BrownDogGadgets/CrazyCircuits/Circuit-Kits/Modules/2x3-Dark-Detector/2x3-Dark-Detector.kicad_pcb

## KiCad design Circuit-Kits/Modules/2x3-Dark-Detector/2x3-Dark-Detector.kicad_pcb (2018-09-25)

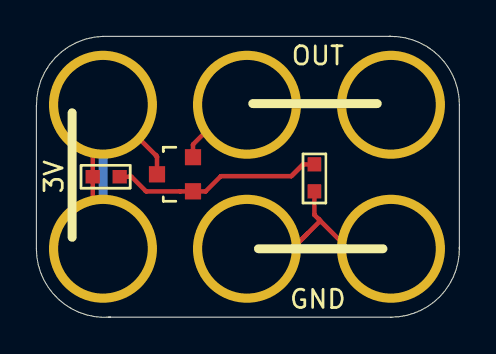
[picture p4: board 2x3-Dark-Detector.kicad_pcb from above]

Board: 2 copper layers, 23.5 x 15.6 mm, 3 parts (0 on the bottom side), 2 nets.

Parts:
LDR1: PHOTOCELL; RLC-0603-SMD
Q1: NPN MMBT3904; SOT-23-3
R1: 100K; RLC-0603-SMD

Connections:
3V: Q1.3, R1.1
unnamed: LDR1.2, Q1.1, R1.2
