BrownDogGadgets/CrazyCircuits/Circuit-Kits/Modules/8x12-PocketBeagle-Breakout/8x12-PocketBeagle-Breakout.kicad_pcb

## KiCad design Circuit-Kits/Modules/8x12-PocketBeagle-Breakout/8x12-PocketBeagle-Breakout.kicad_pcb (2018-08-06)

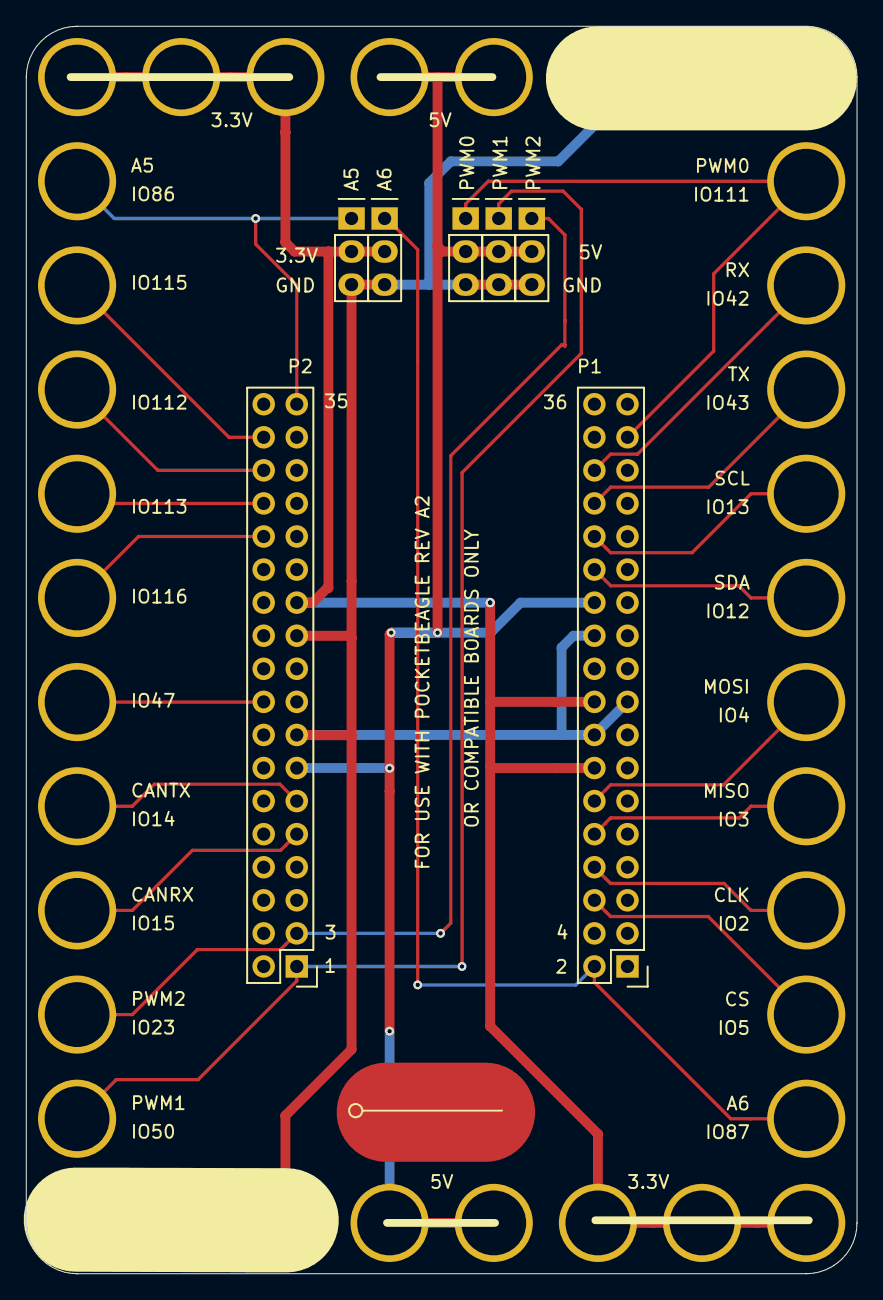
[picture p5: board 8x12-PocketBeagle-Breakout.kicad_pcb from above]

Board: 2 copper layers, 63.8 x 95.8 mm, 7 parts (0 on the bottom side), 8 nets.

Parts:
J1, J2, J3, J4, J5: HEADER; CONN-HEADER-STRAIGHT-P2.54MM-1x03
J6: POCKET-BEAGLE; POCKET-BEAGLE-8x12
LOGO: BROWN DOG; LOGO-CRAZY-1x2

Connections:
3.3V: J4.2, J5.2, J6.P114, J6.P118, J6.P223
5V: J1.2, J2.2, J3.2, J6.P124, J6.P213
/A5: J4.1, J6.P235
/A6: J5.1, J6.P102
/PWM0: J1.1, J6.P133
/PWM1: J2.1, J6.P201
/PWM2: J3.1, J6.P203
GND: J1.3, J2.3, J3.3, J4.3, J5.3, J6.P116, J6.P117, J6.P122, J6.P215, J6.P221
