BrownDogGadgets/CrazyCircuits/Circuit-Kits/Modules/6x10-Photon-Breakout/6x10-Photon-Breakout.kicad_pcb

## KiCad design Circuit-Kits/Modules/6x10-Photon-Breakout/6x10-Photon-Breakout.kicad_pcb (2018-07-31)

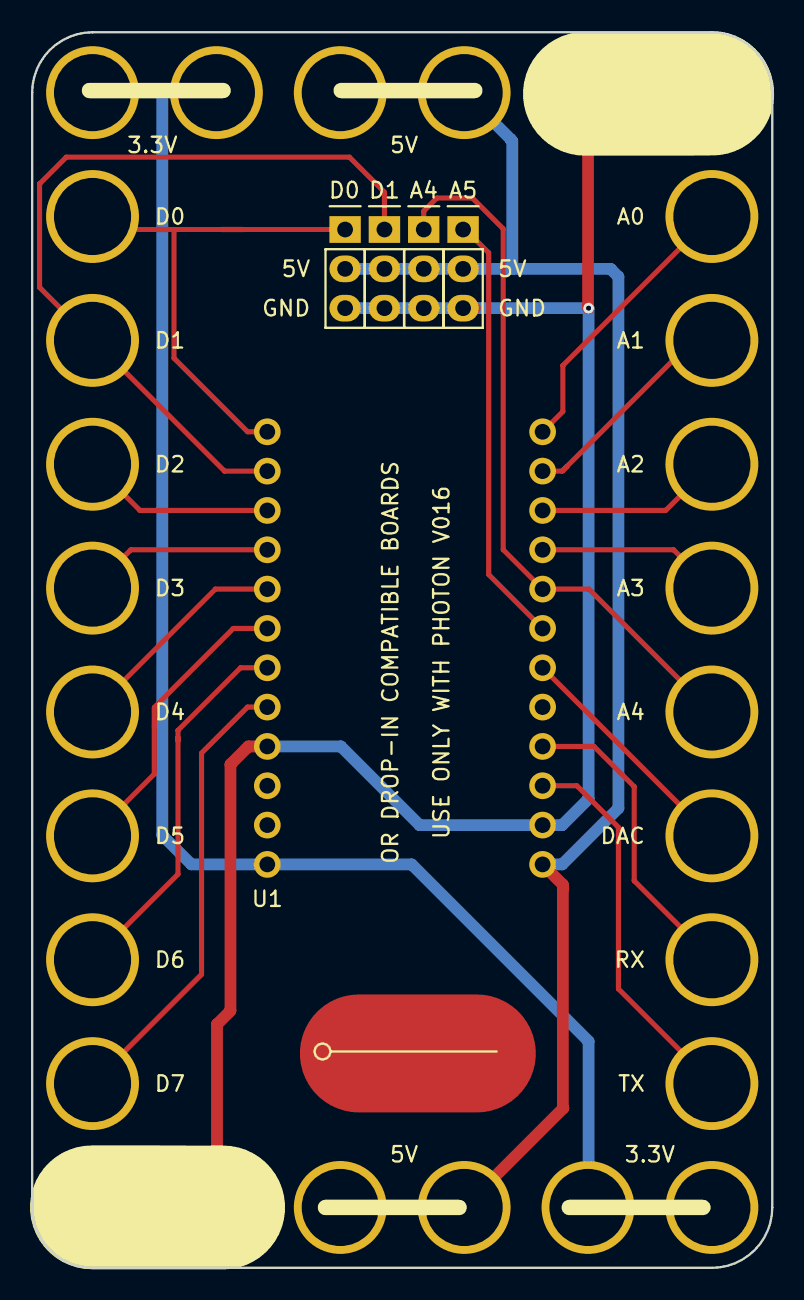
[picture p6: board 6x10-Photon-Breakout.kicad_pcb from above]

Board: 2 copper layers, 47.8 x 79.8 mm, 6 parts (0 on the bottom side), 6 nets.

Parts:
J1, J2, J3: PWM; CONN-HEADER-STRAIGHT-P2.54MM-1x03
J4: Breakout; CONN-HEADER-STRAIGHT-P2.54MM-1x03
LOGO: BROWN DOG; LOGO-CRAZY-1x2
U1: PARTICLE-PHOTON-V016; PHOTON-V016-6x10

Connections:
5V: J1.VIN, J2.VIN, J3.VIN, J4.VIN, U1.5V, U1.VIN
/A4: J3.A4, U1.A4
/A5: J4.A5, U1.A5
/D0: J1.D0, U1.D0
/D1: J2.D1, U1.D1
GND: J1.GND, J2.GND, J3.GND, J4.GND, U1.GND
