BrownDogGadgets/CrazyCircuits/Circuit-Kits/Modules/6x11-NodeMCU-V2-Breakout/6x11-NodeMCU-V2-Breakout.kicad_pcb

## KiCad design Circuit-Kits/Modules/6x11-NodeMCU-V2-Breakout/6x11-NodeMCU-V2-Breakout.kicad_pcb (2018-07-18)

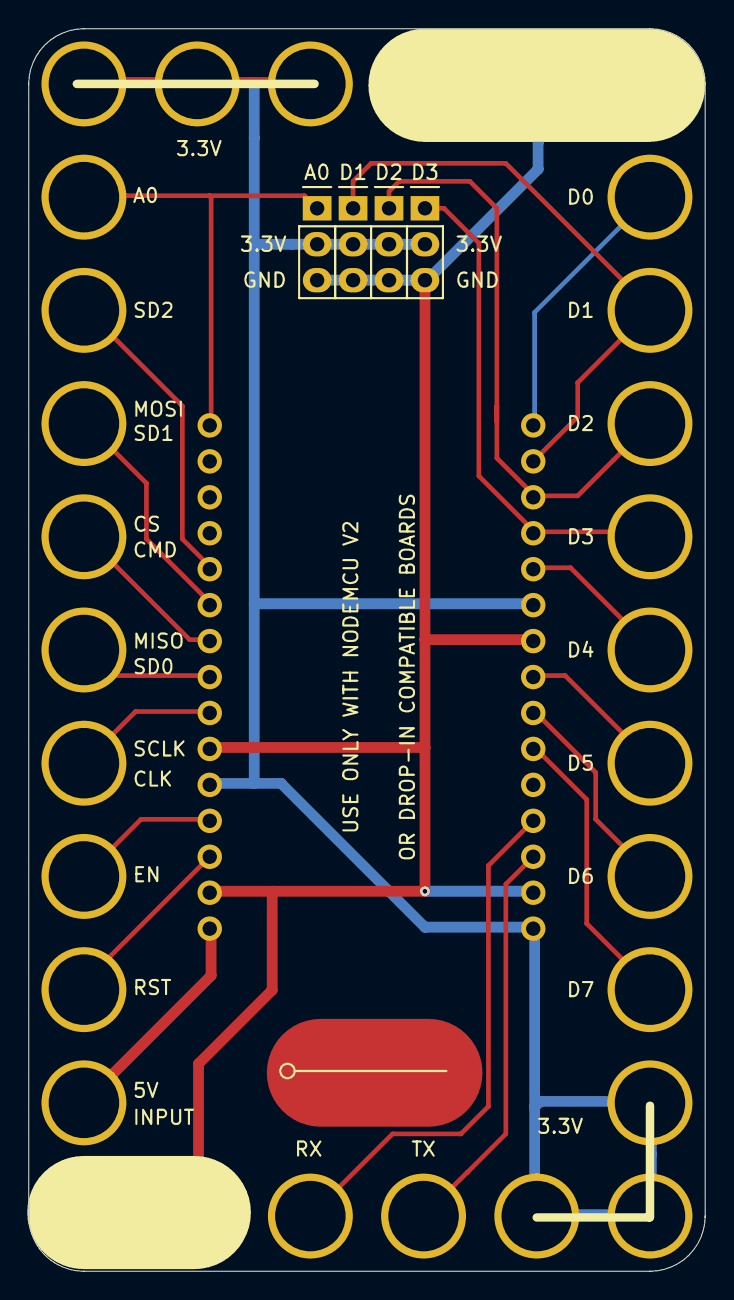
[picture p7: board 6x11-NodeMCU-V2-Breakout.kicad_pcb from above]

Board: 2 copper layers, 47.8 x 87.8 mm, 6 parts (0 on the bottom side), 6 nets.

Parts:
J1, J2, J3, J4: BREAKOUT; CONN-HEADER-STRAIGHT-P2.54MM-1x03
LOGO: BROWN DOG; LOGO-CRAZY-1x2
U1: AMICA-NODEMCU-LUA-V2; NODEMCU-V2-6x11

Connections:
3.3V: J1.2, J2.2, J3.2, J4.2, U1.3V3
/A0: J1.1, U1.A0
/D1: J2.1, U1.D1
/D2: J3.1, U1.D2
/D3: J4.1, U1.D3
GND: J1.3, J2.3, J3.3, J4.3, U1.GND
