BrownDogGadgets/CrazyCircuits/(notices)

Notices in the files:
Circuit-Kits/Modules/3x4-CR2032-Coin-Cell-On-Off-Switch/3x4-CR2032-Coin-Cell-On-Off-Switch.sch:
All rights reserved.
Circuit-Kits/Modules/2x2-Screw-Terminal-3.5mm-Pitch/2x2-Screw-Terminal-3.5mm-Pitch.sch:
CERN Open Hardware License v1.2.
